BenjaminHab/mad-lightning-stick/hardware/logic-board/spotwelder-sch1.png

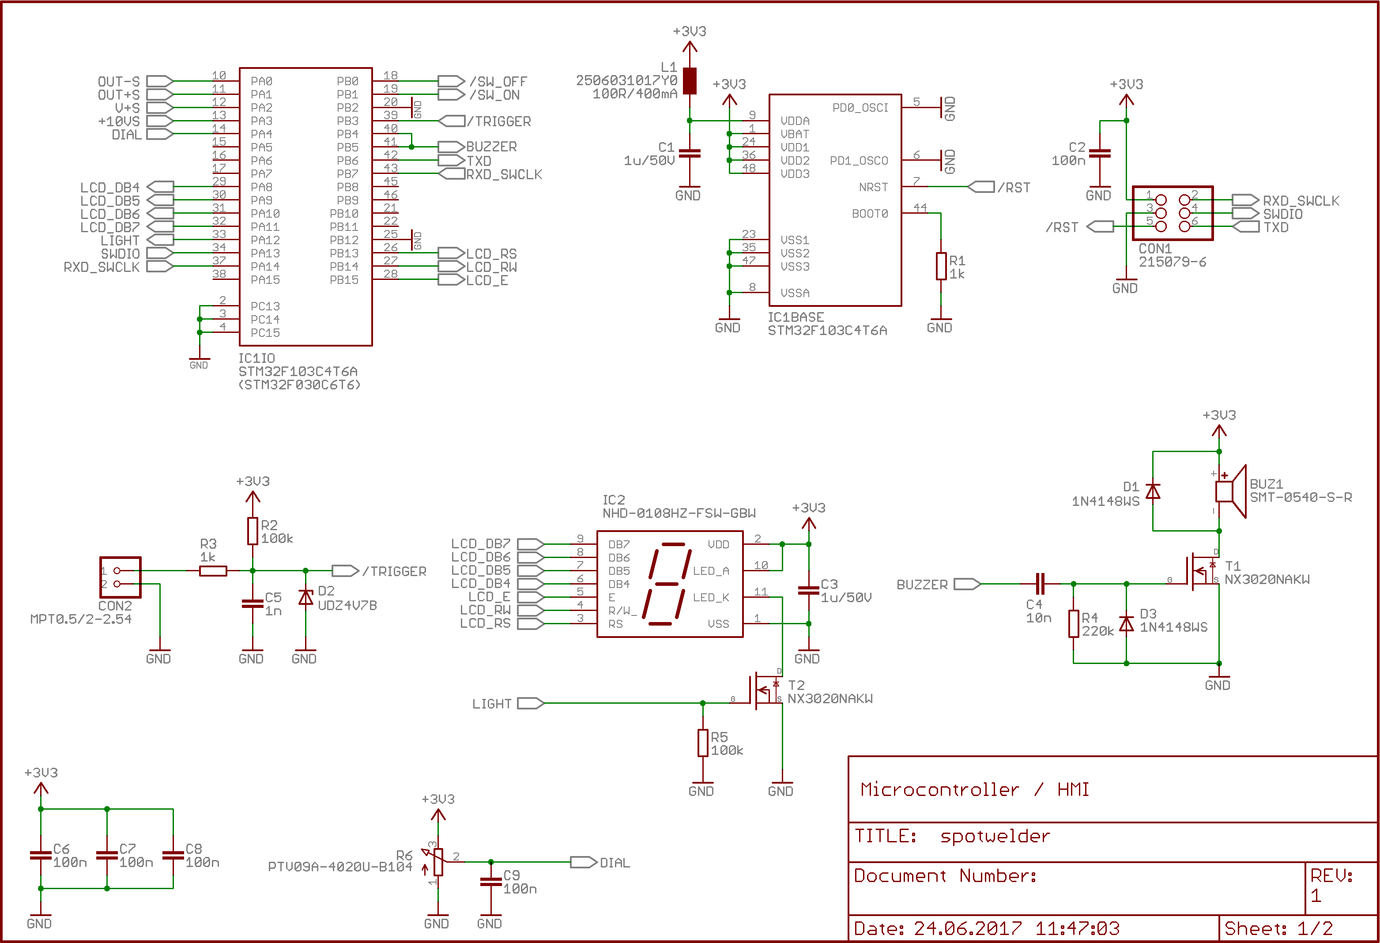
hardware/logic-board/spotwelder-sch1.png
