BenjaminHab/mad-lightning-stick/hardware/logic-board/spotwelder-sch2.png

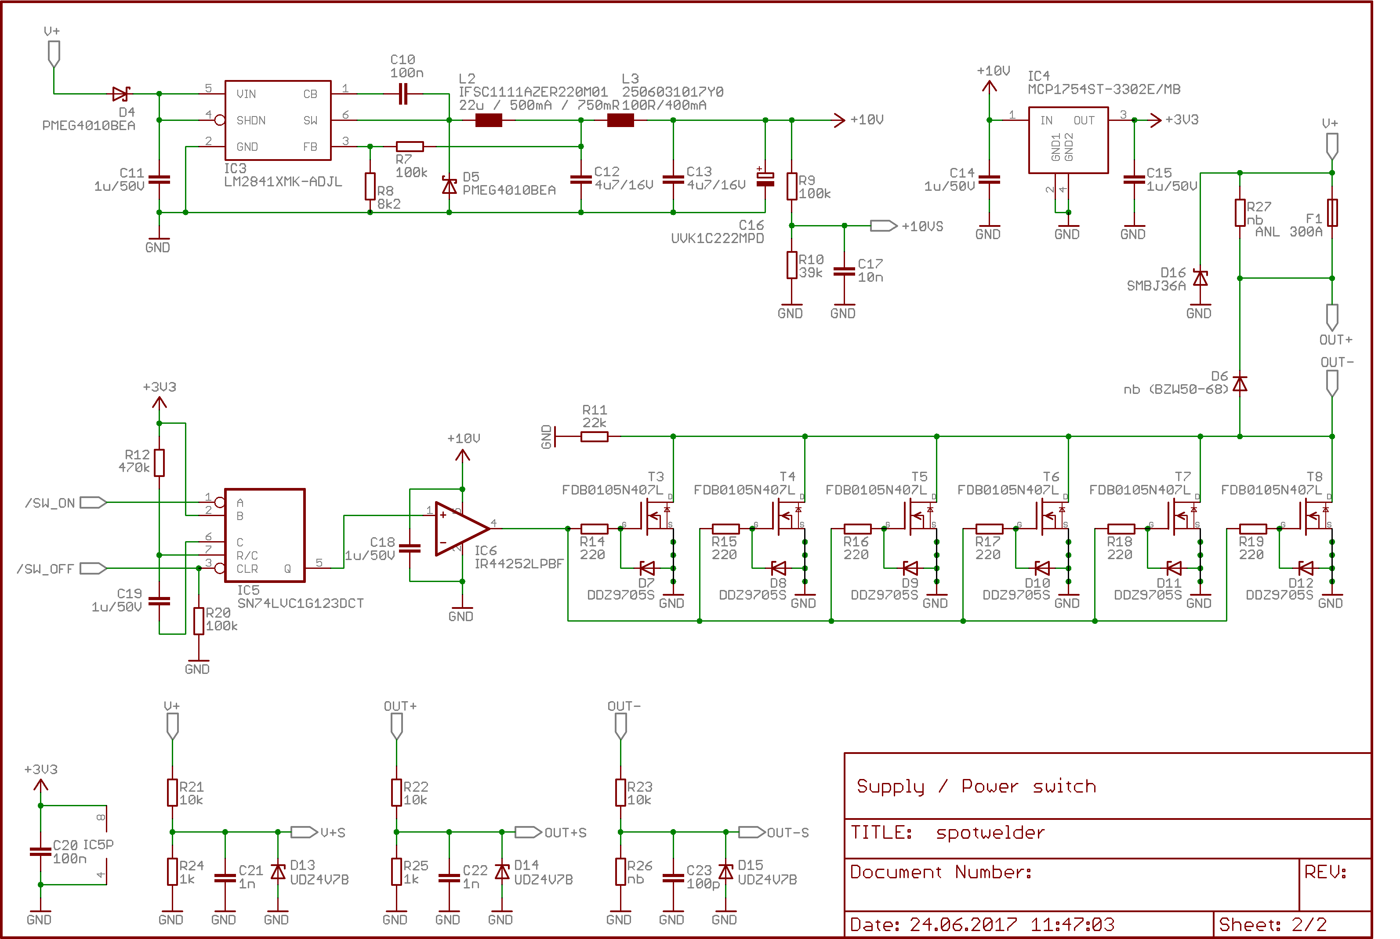
hardware/logic-board/spotwelder-sch2.png
