BenjaminHab/mad-lightning-stick/hardware/logic-board/pawelder_logic_3d_parts.obj

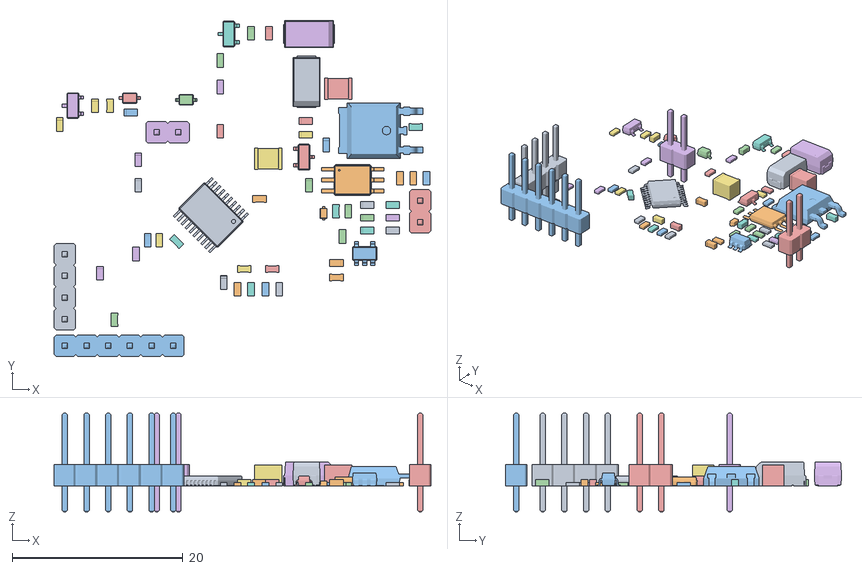
[picture p4: CAD file, 2020-11-03]
hardware/logic-board/pawelder_logic_3d_parts.obj
44.1 x 39.4 x 11.5
