BenjaminHab/mad-lightning-stick/hardware/logic-board/Stencil/Pulse_Arc_Welder_logic-Edge.Cuts.dxf

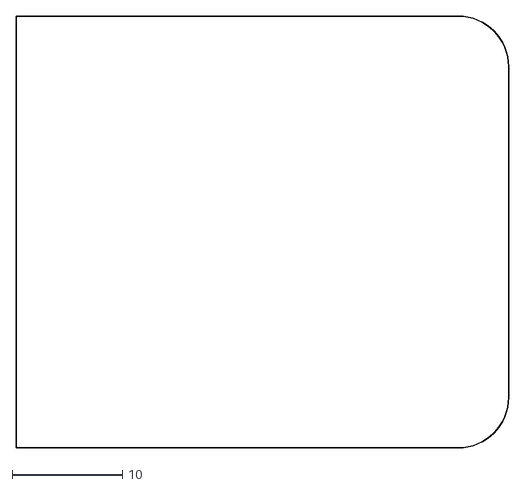
[picture p5: CAD file, 2020-11-03]
hardware/logic-board/Stencil/Pulse_Arc_Welder_logic-Edge.Cuts.dxf
44.7 x 39.2
