BenjaminHab/mad-lightning-stick/hardware/logic-board/Gerber/Pulse_Arc_Welder_logic-Edge_Cuts.dxf

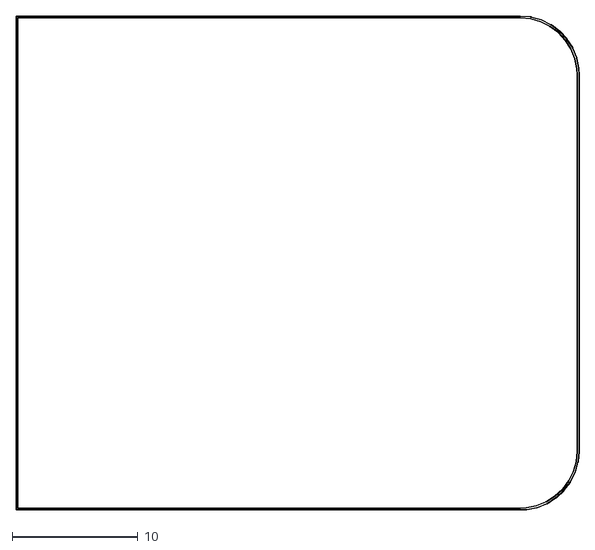
[picture p6: CAD file, 2020-11-03]
hardware/logic-board/Gerber/Pulse_Arc_Welder_logic-Edge_Cuts.dxf
44.8 x 39.4
