BenjaminHab/mad-lightning-stick/hardware/logic-board/pawelder_logic_3d_board.obj

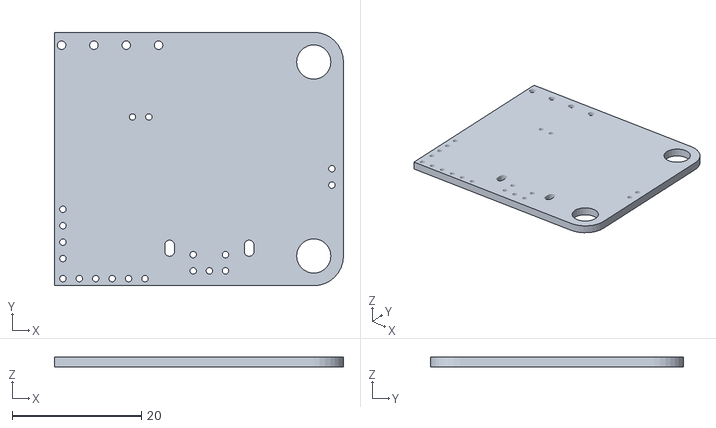
[picture p7: CAD file, 2020-11-03]
hardware/logic-board/pawelder_logic_3d_board.obj
44.7 x 39.2 x 1.60
