BenjaminHab/mad-lightning-stick/hardware/logic-board/Stencil/stencil.stl

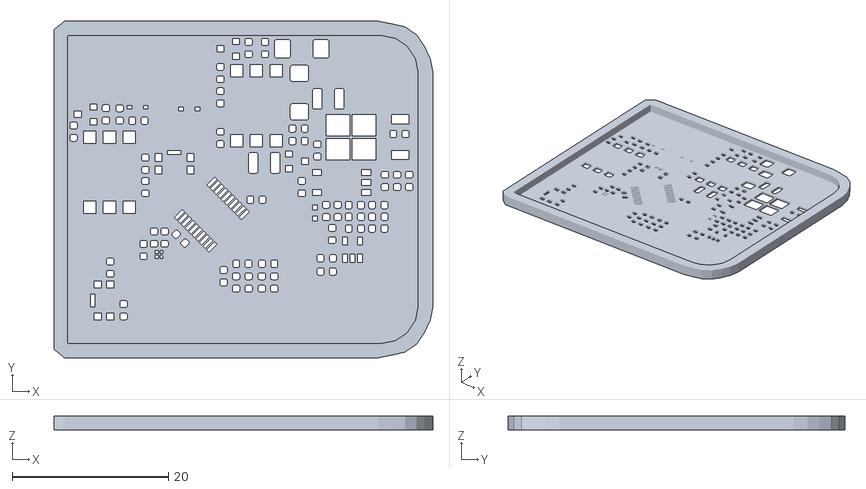
[picture p8: CAD file, 2020-11-03]
hardware/logic-board/Stencil/stencil.stl
48.5 x 43.1 x 1.80
