BenjaminHab/mad-lightning-stick/hardware/logic-board/Gerber/Pulse_Arc_Welder_logic-B_Cu.dxf

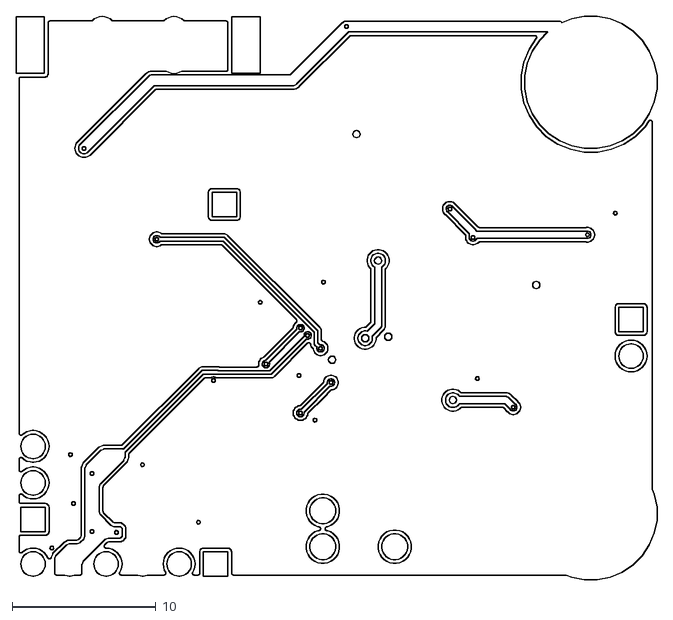
[picture p9: CAD file, 2020-11-03]
hardware/logic-board/Gerber/Pulse_Arc_Welder_logic-B_Cu.dxf
44.6 x 39.2
