BenjaminHab/mad-lightning-stick/hardware/logic-board/pawelder_logic.FCStd

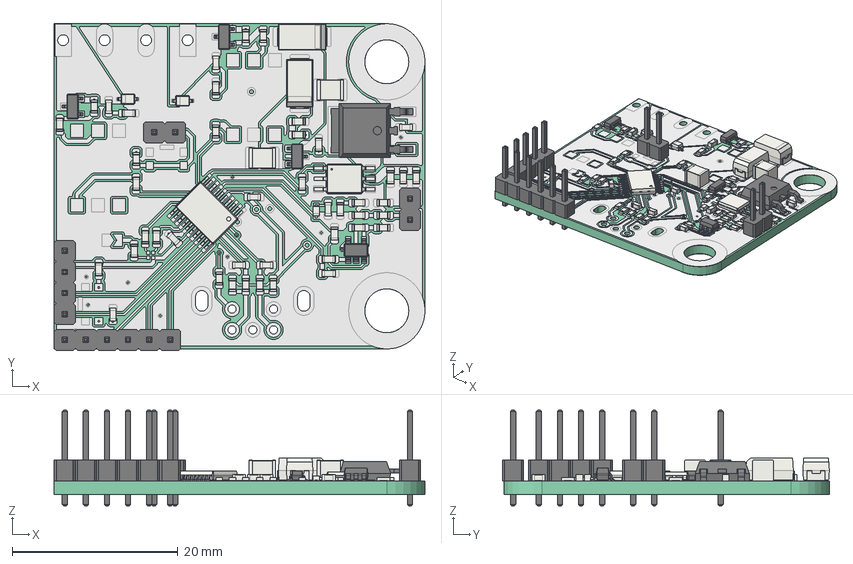
[picture p10: CAD file, 2020-11-03]
hardware/logic-board/pawelder_logic.FCStd
44.7 x 39.4 x 11.5 mm
Pcb
topTracks
botTracks
J5_PinHeader_1x04_P254mm_Vertical_5D2B7882
C14_C_0603_1608Metric_5D2A8FDC
C13_C_0603_1608Metric_5D1FA7F5
U8_SOT_23_5_5D1FA2A7
R34_R_0603_1608Metric_5D2B9920
R35_R_0603_1608Metric_5D1F9F1A
C4_C_1210_3225Metric_5D302AFB
J2_PinHeader_1x02_P254mm_Vertical_5D0663BB
J4_PinHeader_1x02_P254mm_Vertical_5D3E7BC8
U1_TO_252_2_5D3C8292
C5_C_0603_1608Metric_5D06B220
C6_C_0603_1608Metric_5D302B7D
C12_C_0603_1608Metric_5D3D0735
C11_C_0603_1608Metric_5D302B6B
C7_C_0603_1608Metric_5D302B0B
C2_C_1210_3225Metric_5D302AEB
R28_R_0603_1608Metric_5D302303
R29_R_0603_1608Metric_5D3D085B
R30_R_0603_1608Metric_5D3022E1
R31_R_0603_1608Metric_5D3022D0
R32_R_0603_1608Metric_5D3022BF
C10_C_0603_1608Metric_5D2450C5
C9_C_0603_1608Metric_5D2450B4
C8_C_0603_1608Metric_5D245092
C1_CP_EIA_6032_28_Kemet_C_5D245070
C3_CP_EIA_6032_28_Kemet_C_5D24505D
SWD1_PinHeader_1x06_P254mm_Vertical_5D067C02
U6_SO_6_44x36mm_P127mm_5D244F95
D2_D_SOD_323_5D244F80
D3_D_SOD_323_5D066876
D1_D_SOD_523_5D3112F9
U3_TSSOP_20_44x65mm_P065mm_5D244EE0
U2_SOT_23_5D244EBC
Q2_SOT_23_5D3D0799
Q1_SOT_23_5D244E92
R12_R_0603_1608Metric_5D244E55
R19_R_0603_1608Metric_5D3D0765
R10_R_0603_1608Metric_5D244E33
R9_R_0603_1608Metric_5D068CD0
R8_R_0603_1608Metric_5D244E11
R7_R_0603_1608Metric_5D06490D
R1_R_0603_1608Metric_5D244DEF
R2_R_0603_1608Metric_5D244DDE
R3_R_0603_1608Metric_5D244DCD
R4_R_0603_1608Metric_5D244DBC
R5_R_0603_1608Metric_5D244DAB
R11_R_0603_1608Metric_5D244D9A
R20_R_0603_1608Metric_5D244D89
R24_R_0603_1608Metric_5D244D78
R18_R_0603_1608Metric_5D3D07D1
R27_R_0603_1608Metric_5D244D56
R26_R_0603_1608Metric_5D244D45
R25_R_0603_1608Metric_5D244D34
R13_R_0603_1608Metric_5D067DBD
R23_R_0603_1608Metric_5D244D12
R22_R_0603_1608Metric_5D244D01
R21_R_0603_1608Metric_5D244CF0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
