BenjaminHab/mad-lightning-stick/hardware/logic-board/pawelder_logic_3d_top.obj

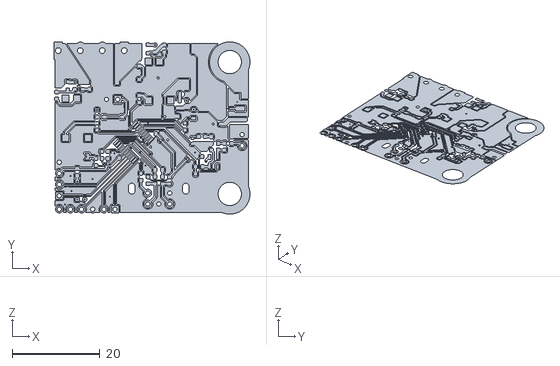
[picture p11: CAD file, 2020-11-03]
hardware/logic-board/pawelder_logic_3d_top.obj
44.6 x 39.2 x 0.04
