BenjaminHab/mad-lightning-stick/(list of files, cad)

Other CAD files:
hardware/logic-board/pawelder_logic_3d.obj
hardware/logic-board/Gerber/Pulse_Arc_Welder_logic-B.Paste.dxf
hardware/logic-board/Gerber/Pulse_Arc_Welder_logic-F.Paste.dxf
hardware/logic-board/Gerber/Pulse_Arc_Welder_logic-F_Paste.dxf
hardware/logic-board/Stencil/Pulse_Arc_Welder_logic-F.Paste.dxf
hardware/logic-board/Stencil_05/Pulse_Arc_Welder_logic-F.Paste.dxf
hardware/logic-board/Stencil_10/Pulse_Arc_Welder_logic-F.Paste.dxf
