BenjaminHab/mad-lightning-stick/hardware/logic-board/Projected Changes.odt

Changes for next iteration:

- Change RGB LED to make the colours work as intended

- Use a processor with more Flash Memory (STM32F07x or STM32G0xx)

- Check for open connections (Current measurement!)
