BenjaminHab/mad-lightning-stick/hardware/logic-board/Pulse_Arc_Welder_logic.pdf

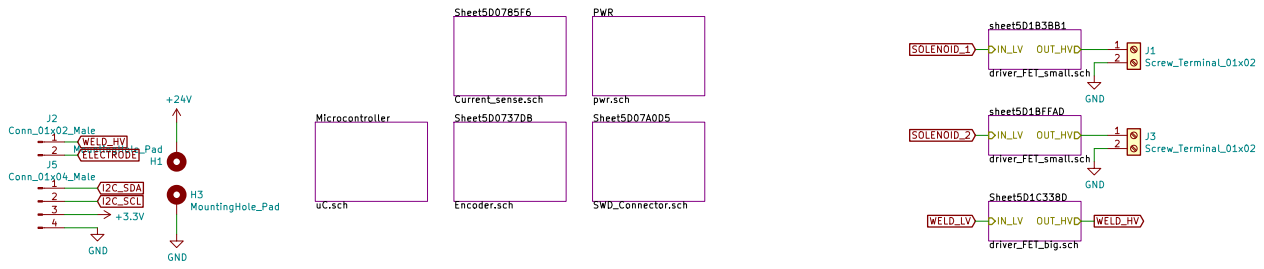
[picture p12: page 1]

pwr.sch Microcontroller uC.sch

File: Pulse_Arc_Welder_logic.sch Sheet: /
Id: 1/9 Title: pawelder logic

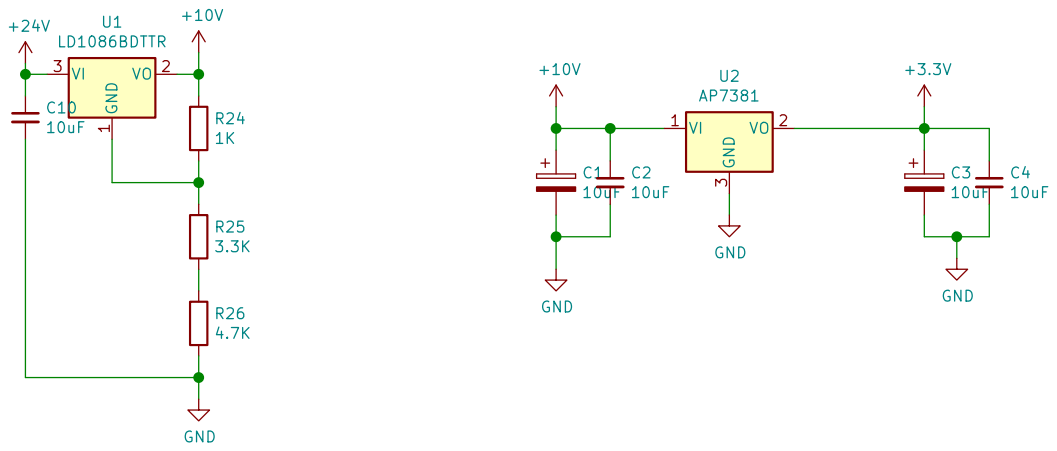
[picture p13: page 2]

3 U2 AP7381 GND GND GND GND

File: pwr.sch Sheet: /PWR/
Id: 2/9 Title: pawelder logic

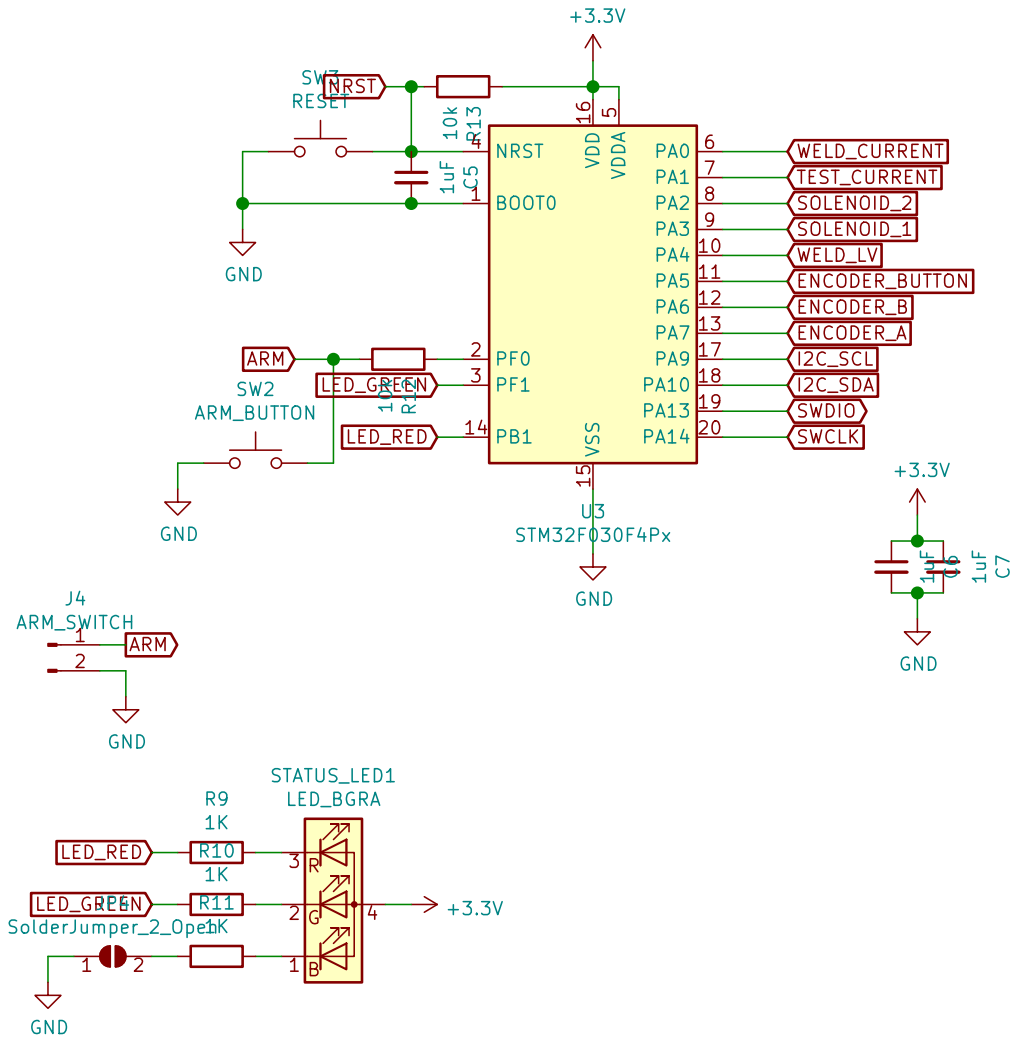
[picture p14: page 3]

File: uC.sch Sheet: /Microcontroller/ 10k R13 SW2 ARM_BUTTON

Id: 3/9 Title: pawelder logic

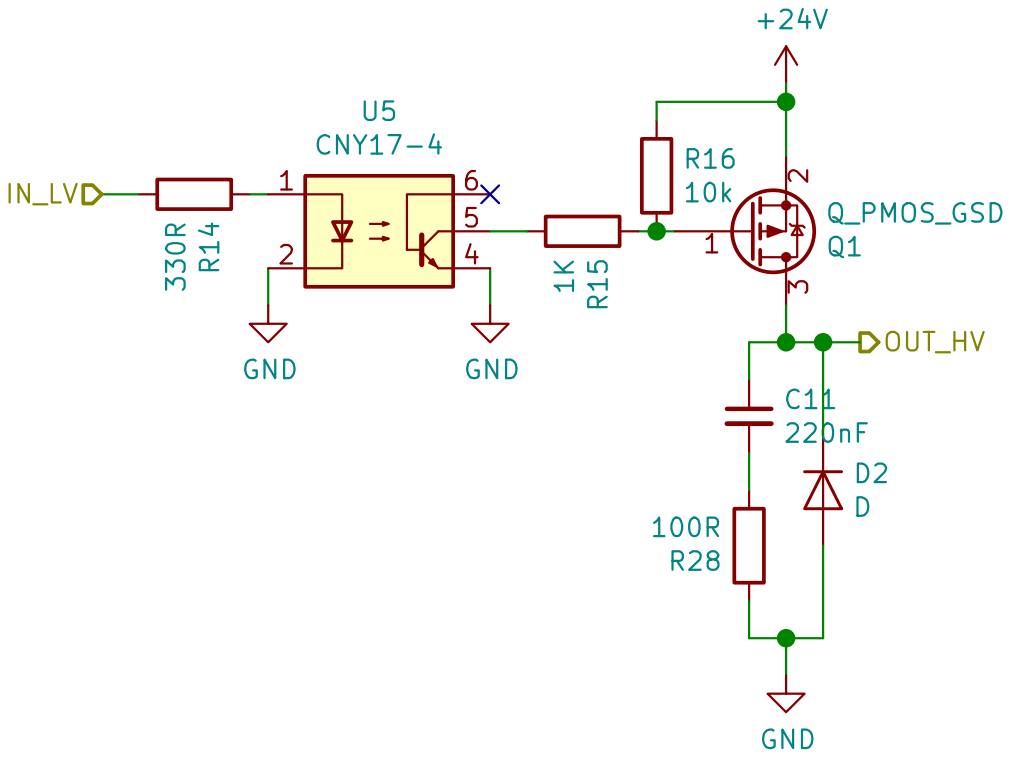
[picture p15: page 4]

File: driver_FET_small.sch Sheet: /sheet5D1B3BB1/
Id: 4/9 Title: pawelder logic

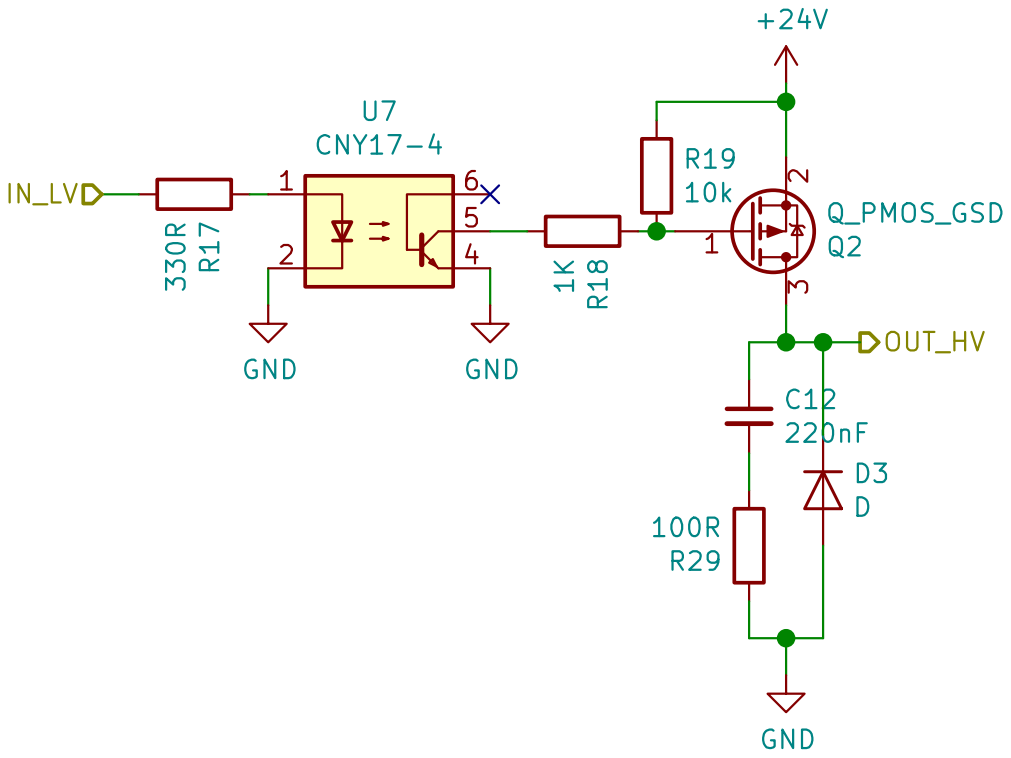
[picture p16: page 5]

File: driver_FET_small.sch Sheet: /sheet5D1BFFAD/
Id: 5/9 Title: pawelder logic

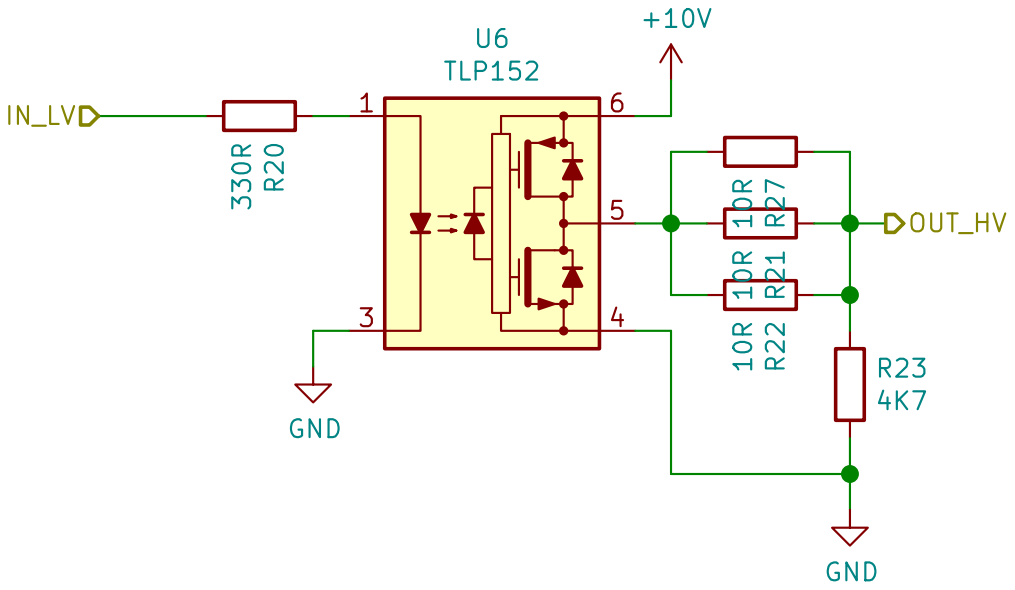
[picture p17: page 6]

File: driver_FET_big.sch Sheet: /Sheet5D1C338D/
Id: 6/9 Title: pawelder logic

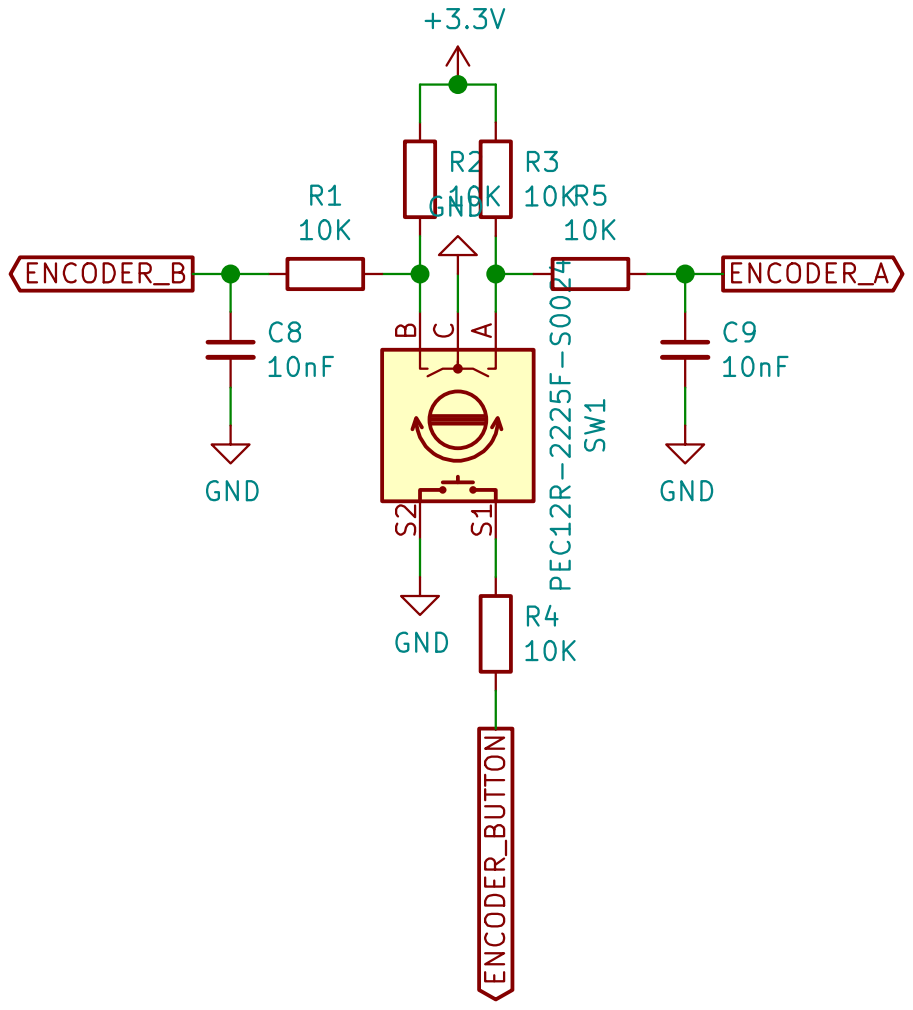
[picture p18: page 7]

File: Encoder.sch Sheet: /Sheet5D0737DB/
Id: 7/9 Title: pawelder logic

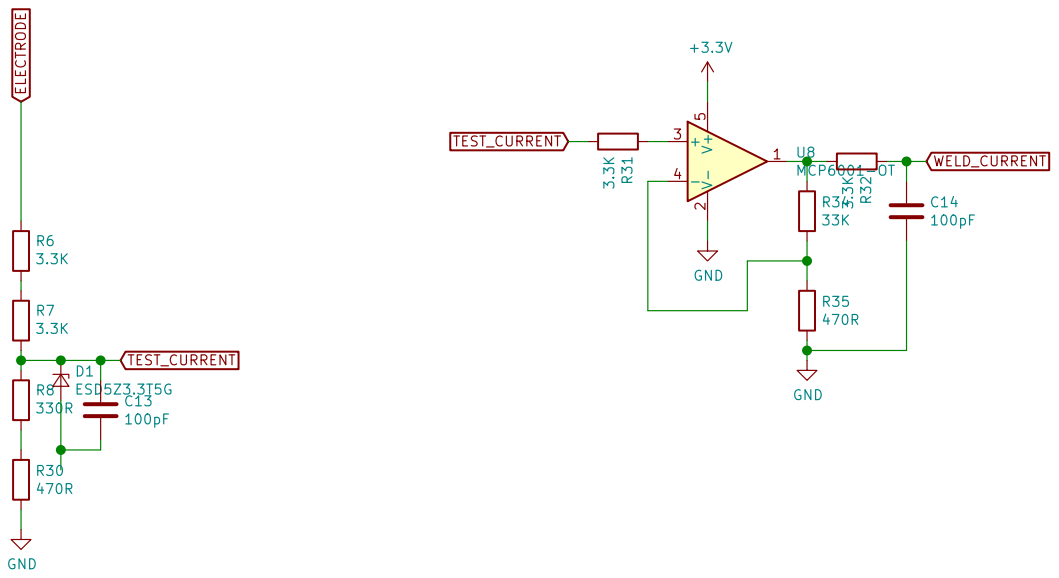
[picture p19: page 8]

File: Current_sense.sch Sheet: /Sheet5D0785F6/
Id: 8/9 Title: pawelder logic

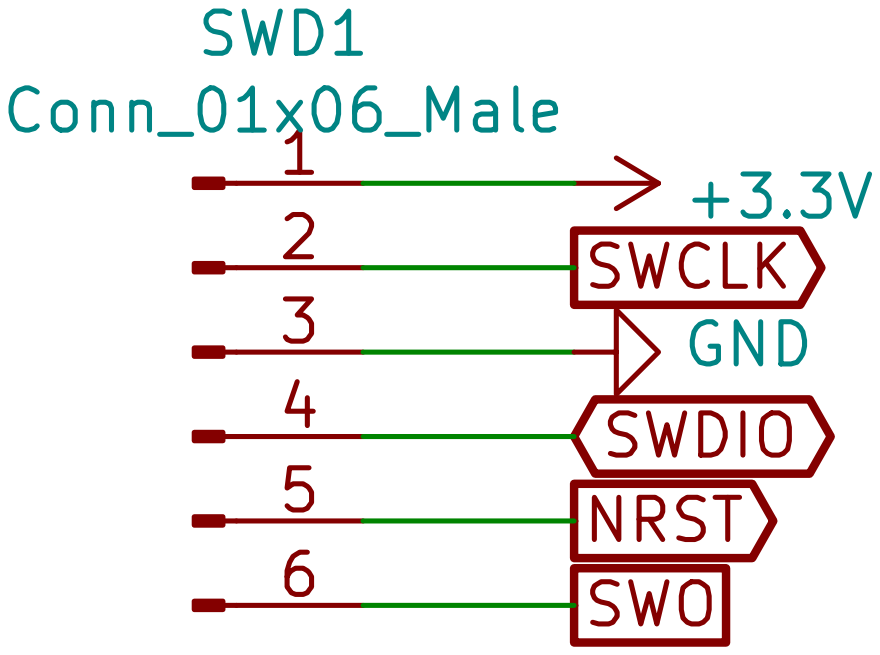
[picture p20: page 9]

File: SWD_Connector.sch Sheet: /Sheet5D07A0D5/
Id: 9/9 Title: pawelder logic
