BenjaminHab/mad-lightning-stick/hardware/power-board/Pulse_Arc_Welder.kicad_pcb

## KiCad design hardware/power-board/Pulse_Arc_Welder.kicad_pcb (2022-05-19)

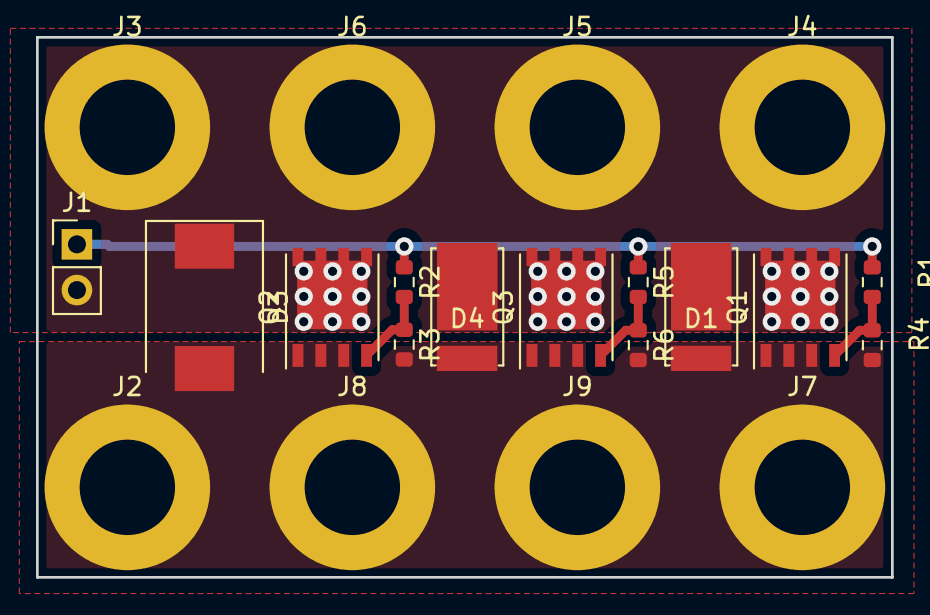
[picture p21: board Pulse_Arc_Welder.kicad_pcb from above]

Board: 2 copper layers, 47.5 x 30.0 mm, 21 parts (0 on the bottom side), 6 nets.

Parts:
D1, D4: SBR10U45SP5; powerdi5
D3: 24V; D_SMC
J1: to logic board; PinHeader_1x02_P2.54mm_Vertical
J2, J7, J8, J9: BAT-; MountingHole_5.3mm_M5_DIN965_Pad
J3, J4, J5, J6: Electrode; MountingHole_5.3mm_M5_DIN965_Pad
Q1, Q2, Q3: SIR500DP-T1-RE3; PowerPAK_SO-8_Single
R1, R2, R5: 10R; R_0603_1608Metric
R3, R4, R6: 10k; R_0603_1608Metric

Connections:
Electrode: D1.1 (K), D3.1 (K), D4.1 (K), J1.2, J3.1, J4.1, J5.1, J6.1, Q1.5 (D), Q2.5 (D), Q3.5 (D)
GND: D1.2 (A), D3.2 (A), D4.2 (A), J2.1, J7.1, J8.1, J9.1, Q1.1 (S), Q1.2 (S), Q1.3 (S), Q2.1 (S), Q2.2 (S), Q2.3 (S), Q3.1 (S), Q3.2 (S), Q3.3 (S), R3.2, R4.2, R6.2
unnamed: Q2.4 (G), R2.2, R3.1
unnamed: Q3.4 (G), R5.2, R6.1
unnamed: Q1.4 (G), R1.2, R4.1
SIG: J1.1, R1.1, R2.1, R5.1
