BenjaminHab/mad-lightning-stick/hardware/logic-board/Pulse_Arc_Welder_logic.kicad_pcb

## KiCad design hardware/logic-board/Pulse_Arc_Welder_logic.kicad_pcb (2020-11-03)

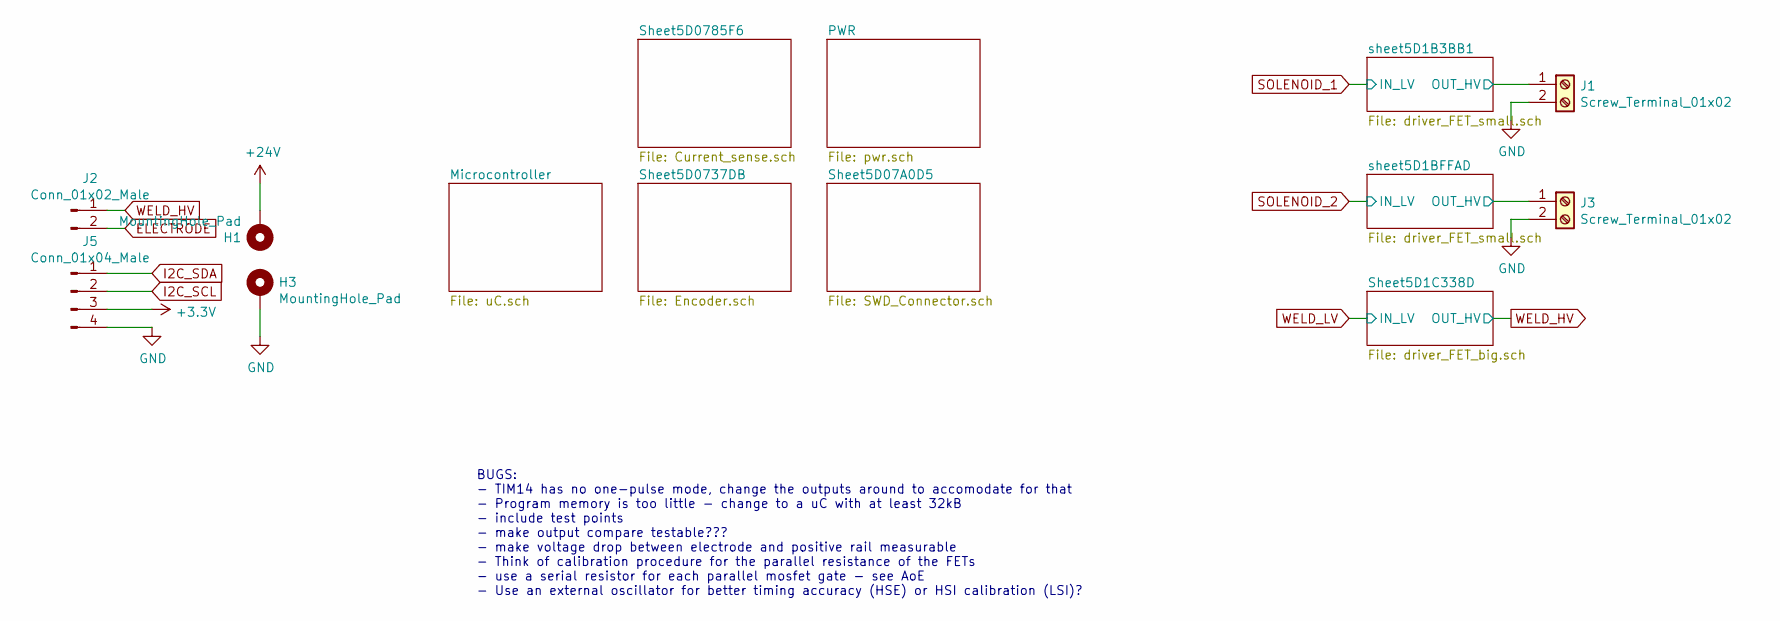
[picture p22: schematic Pulse_Arc_Welder_logic.sch, pawelder logic]

Parts:
H1, H3: MountingHole_Pad; MountingHole_5.3mm_M5_DIN965_Pad
J1, J3: Screw_Terminal_01x02; TerminalBlock_Altech_AK300-2_P5.00mm
J2: Conn_01x02_Male; PinHeader_1x02_P2.54mm_Vertical
J5: Conn_01x04_Male; PinHeader_1x04_P2.54mm_Vertical

Connections:
+3V3: J5.3; also elsewhere on the board
+24V: H1.1; also elsewhere on the board
/sheet5D1B3BB1/OUT_HV: J1.1; also elsewhere on the board
/sheet5D1BFFAD/OUT_HV: J3.1; also elsewhere on the board
ELECTRODE: J2.2; also elsewhere on the board
I2C_SCL: J5.2; also elsewhere on the board
I2C_SDA: J5.1; also elsewhere on the board
WELD_HV: J2.1; also elsewhere on the board

Notes on the sheet:
BUGS: - TIM14 has no one-pulse mode, change the outputs around to accomodate for that - Program memory is too little - change to a uC with at least 32kB - include test points - make output compare testable??? - make voltage drop between electrode and positive rail measurable - Think of calibration 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

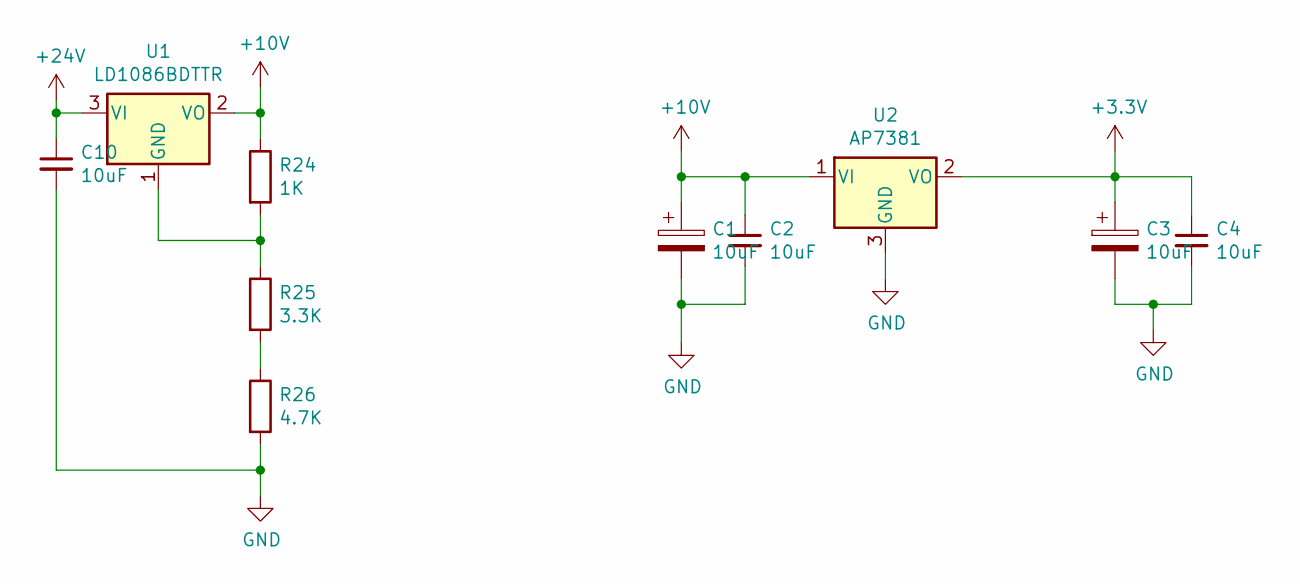
[picture p23: schematic pwr.sch, pawelder logic]

Parts:
C1, C3: 10uF; CP_EIA-6032-28_Kemet-C
C2, C4: 10uF; C_1210_3225Metric
C10: 10uF; C_0603_1608Metric
R24: 1K; R_0603_1608Metric
R25: 3.3K; R_0603_1608Metric
R26: 4.7K; R_0603_1608Metric
U1: LD1086BDTTR; TO-252-2
U2: AP7381; SOT-23

Connections:
+3V3: C3.1, C4.1, U2.2 (VO); also elsewhere on the board
+10V: C1.1, C2.1, R24.1, U1.2 (VO), U2.1 (VI); also elsewhere on the board
+24V: C10.1, U1.3 (VI); also elsewhere on the board
unnamed: R24.2, R25.1, U1.1 (GND)
unnamed: R25.2, R26.1

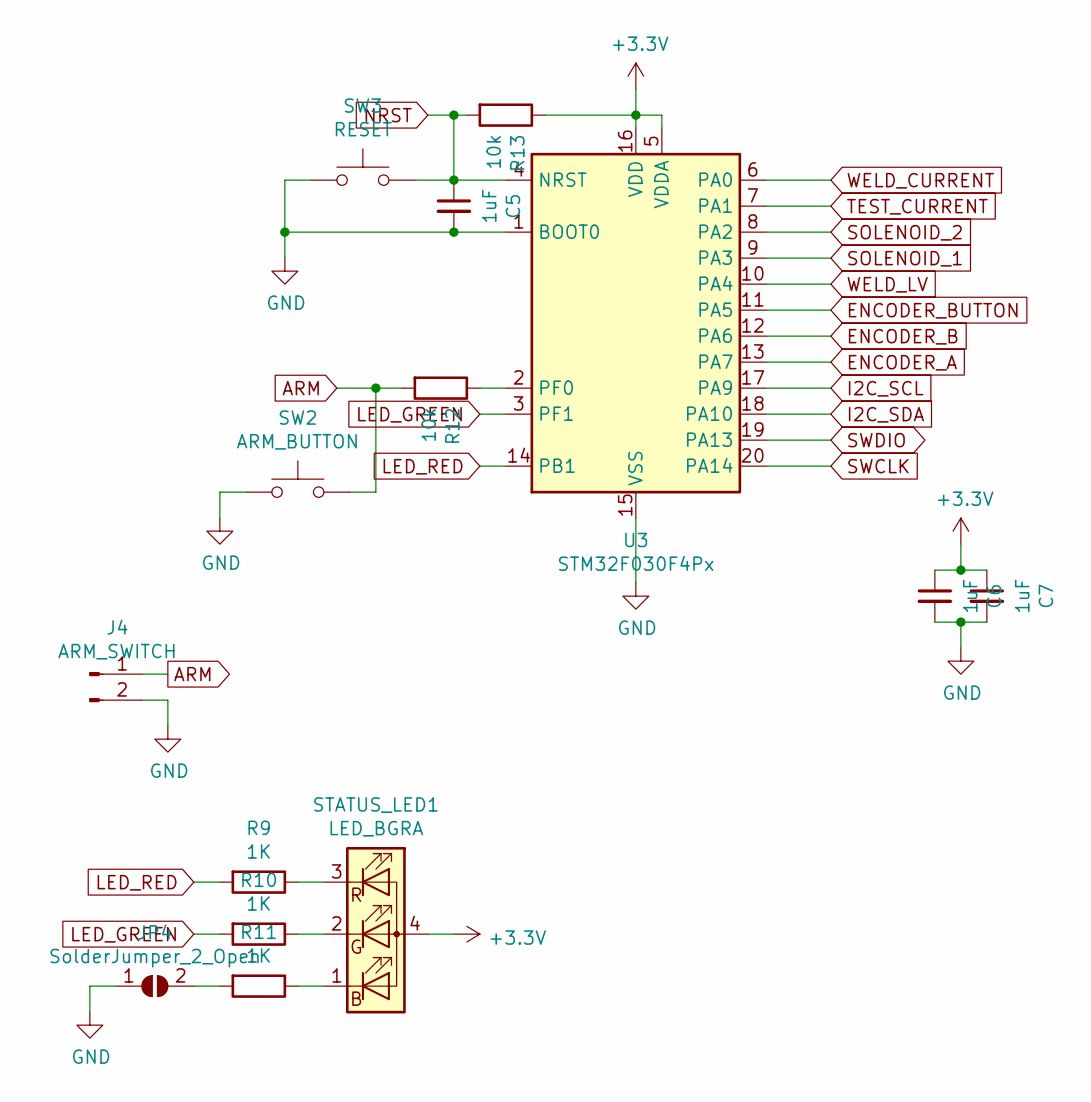
[picture p24: schematic uC.sch, pawelder logic]

Parts:
C5, C6, C7: 1uF; C_0603_1608Metric
J4: ARM_SWITCH; PinHeader_1x02_P2.54mm_Vertical
JP4: SolderJumper_2_Open; SolderJumper-2_P1.3mm_Open_TrianglePad1.0x1.5mm
R9, R10, R11: 1K; R_0603_1608Metric
R12, R13: 10k; R_0603_1608Metric
STATUS_LED1: LED_BGRA
SW2: ARM_BUTTON; KMR7_SWITCH
SW3: RESET; KMR7_SWITCH
U3: STM32F030F4Px; TSSOP-20_4.4x6.5mm_P0.65mm

Connections:
+3V3: C6.1, C7.1, R13.1, STATUS_LED1.4 (A), U3.5 (VDDA), U3.16 (VDD); also elsewhere on the board
ARM: J4.1, R12.2, SW2.2
ENCODER_A: U3.13 (PA7); also elsewhere on the board
ENCODER_B: U3.12 (PA6); also elsewhere on the board
ENCODER_BUTTON: U3.11 (PA5); also elsewhere on the board
I2C_SCL: U3.17 (PA9); also elsewhere on the board
I2C_SDA: U3.18 (PA10); also elsewhere on the board
LED_GREEN: R10.2, U3.3 (PF1)
LED_RED: R9.2, U3.14 (PB1)
NRST: C5.1, R13.2, SW3.2, U3.4 (NRST); also elsewhere on the board
unnamed: JP4.2 (B), R11.2
unnamed: R9.1, STATUS_LED1.3 (RK)
unnamed: R10.1, STATUS_LED1.2 (GK)
unnamed: R11.1, STATUS_LED1.1 (BK)
unnamed: R12.1, U3.2 (PF0)
SOLENOID_1: U3.9 (PA3); also elsewhere on the board
SOLENOID_2: U3.8 (PA2); also elsewhere on the board
SWCLK: U3.20 (PA14); also elsewhere on the board
SWDIO: U3.19 (PA13); also elsewhere on the board
TEST_CURRENT: U3.7 (PA1); also elsewhere on the board
WELD_CURRENT: U3.6 (PA0); also elsewhere on the board
WELD_LV: U3.10 (PA4); also elsewhere on the board

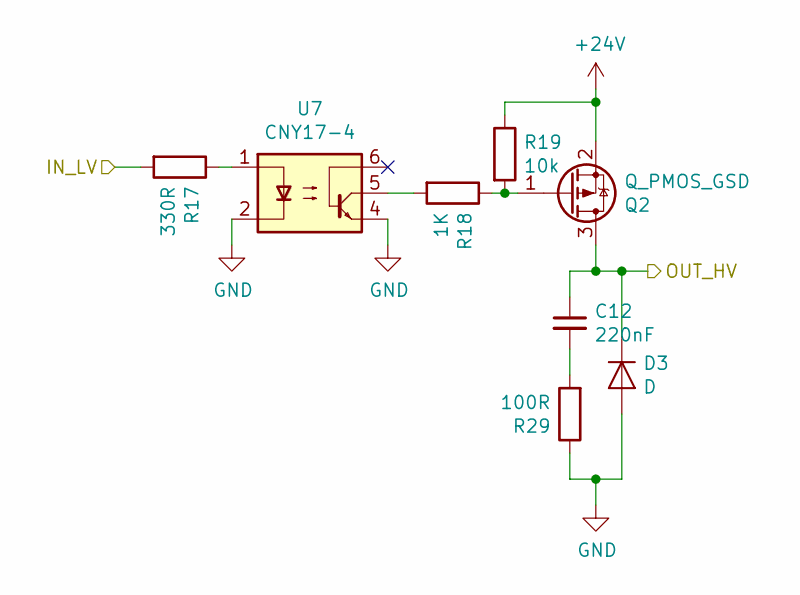
[picture p25: schematic driver_FET_small.sch, pawelder logic]

Parts:
C11: 220nF; C_0603_1608Metric
D2: D; D_SOD-323
Q1: Q_PMOS_GSD; SOT-23
R14: 330R; R_0603_1608Metric
R15: 1K; R_0603_1608Metric
R16: 10k; R_0603_1608Metric
R28: 100R; R_0603_1608Metric
U7: CNY17-4; PDIP-6

Connections:
+24V: Q1.2 (S), R16.1; also elsewhere on the board
/sheet5D1B3BB1/OUT_HV: C11.1, D2.1 (K), Q1.3 (D); also elsewhere on the board
unnamed: C11.2, R28.2
unnamed: Q1.1 (G), R15.1, R16.2
SOLENOID_1: R14.2; also elsewhere on the board

Parts of its further copies:
C12: 220nF; C_0603_1608Metric
D3: D; D_SOD-323
Q2: Q_PMOS_GSD; SOT-23
R17: 330R; R_0603_1608Metric
R18: 1K; R_0603_1608Metric
R19: 10k; R_0603_1608Metric
R29: 100R; R_0603_1608Metric
U5: CNY17-4; PDIP-6

Connections of its further copies:
+24V: Q2.2 (S), R19.1; also elsewhere on the board
/sheet5D1BFFAD/OUT_HV: C12.1, D3.1 (K), Q2.3 (D); also elsewhere on the board
unnamed: C12.2, R29.2
unnamed: Q2.1 (G), R18.1, R19.2
SOLENOID_2: R17.2; also elsewhere on the board

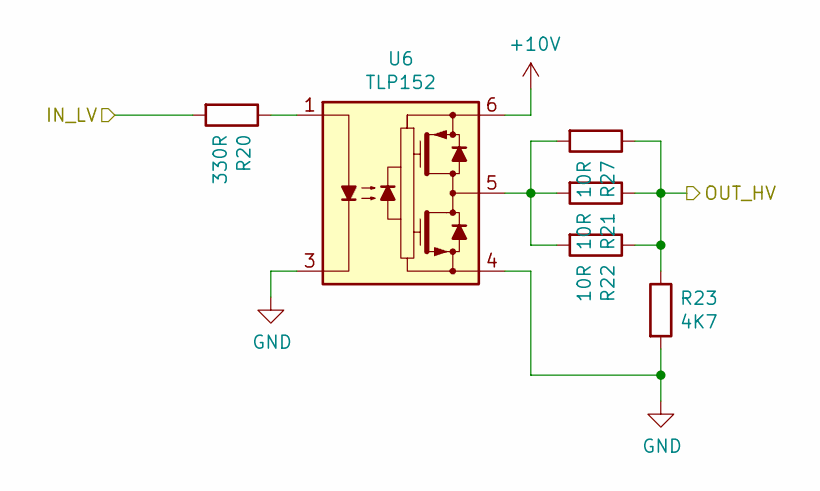
[picture p26: schematic driver_FET_big.sch, pawelder logic]

Parts:
R20: 330R; R_0603_1608Metric
R21, R22, R27: 10R; R_0603_1608Metric
R23: 4K7; R_0603_1608Metric
U6: TLP152; SO-6_5PIN

Connections:
+10V: U6.6 (VCC); also elsewhere on the board
unnamed: R20.1, U6.1 (A)
unnamed: R21.2, R22.2, R27.2, U6.5 (VO)
WELD_HV: R21.1, R22.1, R23.1, R27.1; also elsewhere on the board
WELD_LV: R20.2; also elsewhere on the board

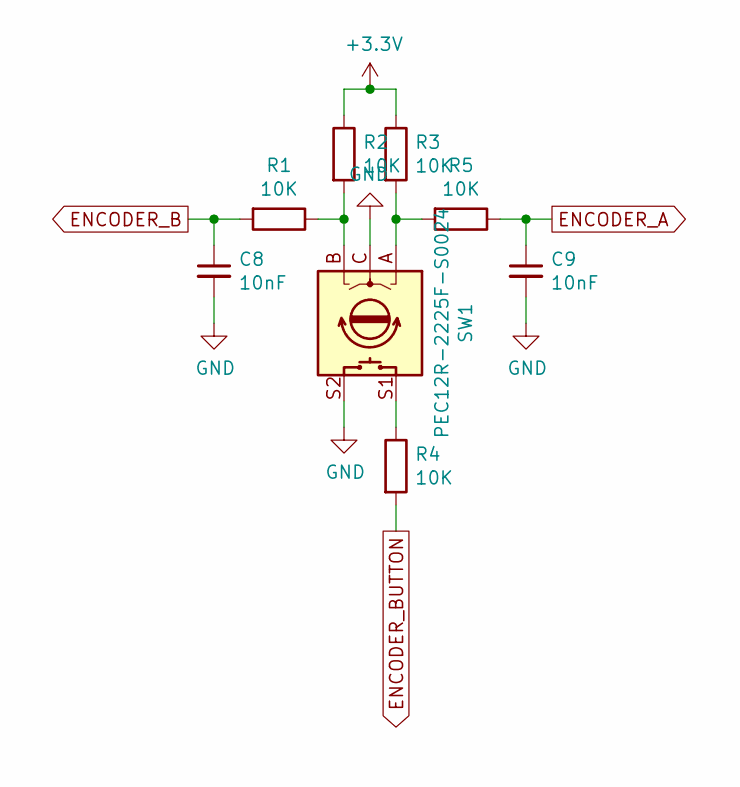
[picture p27: schematic Encoder.sch, pawelder logic]

Parts:
C8, C9: 10nF; C_0603_1608Metric
R1, R2, R3, R4, R5: 10K; R_0603_1608Metric
SW1: PEC12R-2225F-S0024; ENCODER_BOURNS

Connections:
+3V3: R2.1, R3.1; also elsewhere on the board
ENCODER_A: C9.1, R5.1; also elsewhere on the board
ENCODER_B: C8.1, R1.2; also elsewhere on the board
ENCODER_BUTTON: R4.2; also elsewhere on the board
unnamed: R1.1, R2.2, SW1.B
unnamed: R3.2, R5.2, SW1.A
unnamed: R4.1, SW1.S1

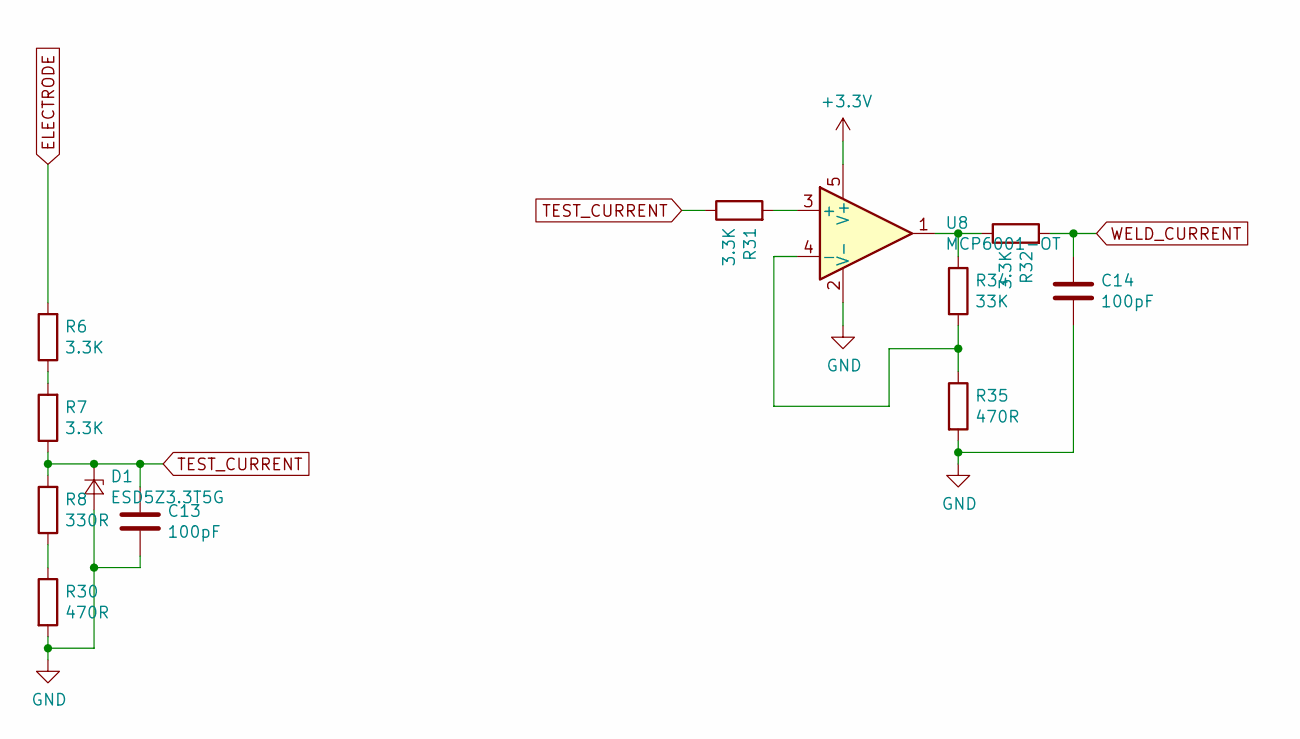
[picture p28: schematic Current_sense.sch, pawelder logic]

Parts:
C13, C14: 100pF; C_0603_1608Metric
D1: ESD5Z3.3T5G; D_SOD-523
R6, R7, R31, R32: 3.3K; R_0603_1608Metric
R8: 330R; R_0603_1608Metric
R30, R35: 470R; R_0603_1608Metric
R34: 33K; R_0603_1608Metric
U8: MCP6001-OT; SOT-23-5

Connections:
+3V3: U8.5 (V+); also elsewhere on the board
ELECTRODE: R6.2; also elsewhere on the board
unnamed: R6.1, R7.2
unnamed: R8.1, R30.1
unnamed: R31.2, U8.3 (+)
unnamed: R32.1, R34.1, U8.1
unnamed: R34.2, R35.1, U8.4 (-)
TEST_CURRENT: C13.1, D1.1 (K), R7.1, R8.2, R31.1; also elsewhere on the board
WELD_CURRENT: C14.1, R32.2; also elsewhere on the board

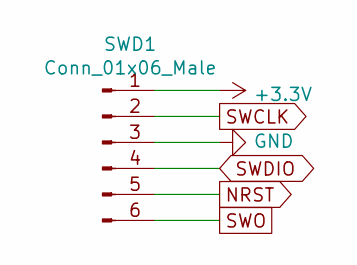
[picture p29: schematic SWD_Connector.sch, pawelder logic]

Parts:
SWD1: Conn_01x06_Male; PinHeader_1x06_P2.54mm_Vertical

Connections:
+3V3: SWD1.1; also elsewhere on the board
NRST: SWD1.5; also elsewhere on the board
SWCLK: SWD1.2; also elsewhere on the board
SWDIO: SWD1.4; also elsewhere on the board
SWO: SWD1.6

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
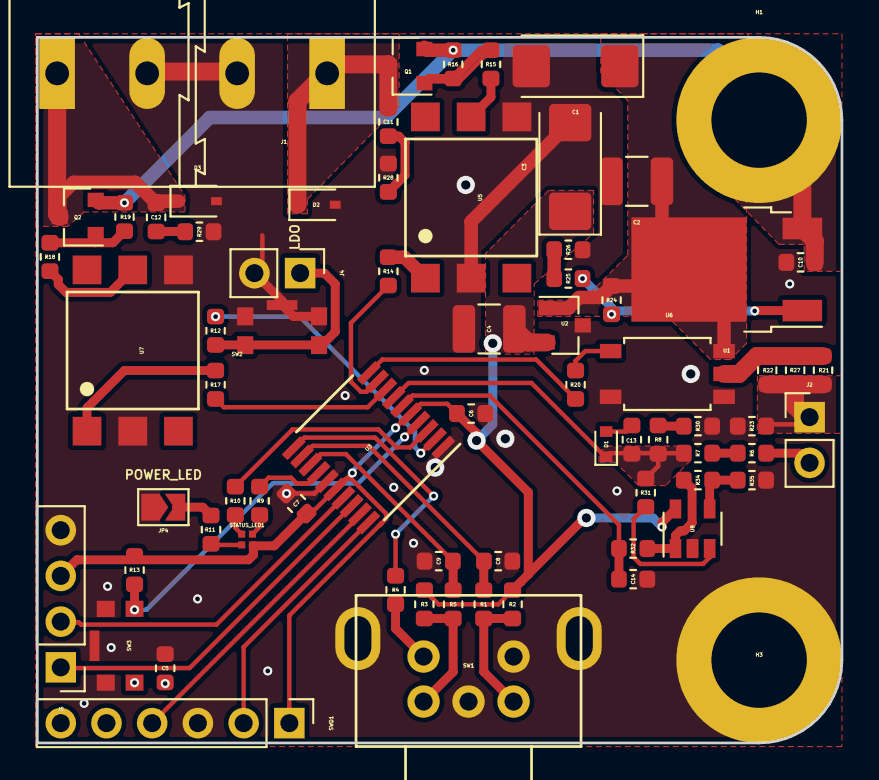
[picture p30: board Pulse_Arc_Welder_logic.kicad_pcb from above]

Board: 2 copper layers, 44.7 x 39.2 mm, 73 parts (0 on the bottom side), 50 nets.
