BenjaminHab/mad-lightning-stick/hardware/logic-board/Pulse_Arc_Welder_logic_r2.kicad_pcb

## KiCad design hardware/logic-board/Pulse_Arc_Welder_logic_r2.kicad_pcb (2020-11-03)

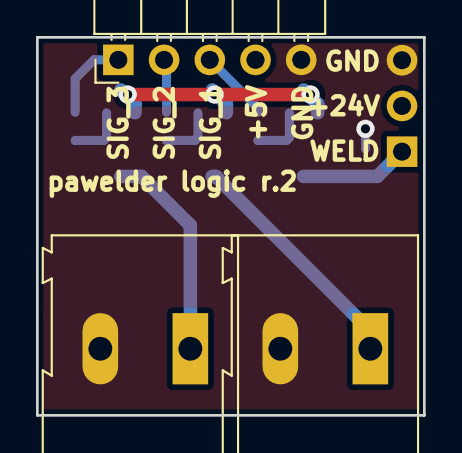
[picture p31: board Pulse_Arc_Welder_logic_r2.kicad_pcb from above]

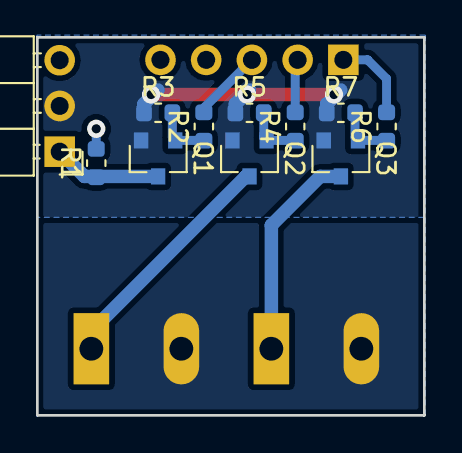
[picture p32: board Pulse_Arc_Welder_logic_r2.kicad_pcb from below]

Board: 2 copper layers, 21.5 x 21.0 mm, 14 parts (11 on the bottom side), 11 nets.

Parts:
J1, J4: Screw_Terminal_01x02; TerminalBlock_Altech_AK300-2_P5.00mm
J2: Conn_01x03_Male; PinHeader_1x03_P2.54mm_Horizontal
J3: Conn_01x05_Male; PinHeader_1x05_P2.54mm_Horizontal
Q1, Q2, Q3: Q_PMOS_GSD; SOT-23
R1, R3, R5, R7: 10k; R_0603_1608Metric
R2, R4, R6: 100; R_0603_1608Metric

Connections:
+24V: J2.2, Q1.2, Q2.2, Q3.2, R3.1, R5.1, R7.1
GND: J1.2, J2.3, J3.5, J4.2, R1.2
unnamed: J1.1, Q3.3
unnamed: J4.1, Q2.3
unnamed: Q1.1, R2.1, R3.2
unnamed: Q2.1, R4.1, R5.2
unnamed: Q3.1, R6.1, R7.2
SIG_1: J3.3, R2.2
SIG_2: J3.2, R4.2
SIG_3: J3.1, R6.2
WELD: J2.1, Q1.3, R1.1
