BenjaminHab/mad-lightning-stick/software/Core/Src/main.cpp

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
/* Includes ------------------------------------------------------------------*/
#include "main.h"
#include "adc.h"
#include "i2c.h"
#include "tim.h"
#include "gpio.h"

/* USER CODE BEGIN Includes */
//TODO: Use Fixed point math library
//#include "fpm/fixed.hpp"


//Modules
#include "Modules.hpp"

/* USER CODE END Includes */


void SystemClock_Config(void);
/**
 * @brief  The application entry point.
 * @retval int
 */
int main(void)
{
	/* MCU Configuration--------------------------------------------------------*/

	/* Reset of all peripherals, Initializes the Flash interface and the Systick. */
	HAL_Init();

	/* Configure the system clock */
	//SystemClock_Config();

	/* USER CODE BEGIN SysInit */
	RCC_Interface rcc;
	rcc.set_system_clock(PLL);

	/* USER CODE END SysInit */

	/* Initialize all configured peripherals */
	//MX_GPIO_Init();
	//MX_ADC_Init();
	MX_I2C1_Init();
	//MX_TIM14_Init();
	//MX_TIM3_Init();
	//	MX_TIM16_Init();
	/* USER CODE BEGIN 2 */
	//TODO: Initialize Peripherals myself and save lots of memory
	//TODO: Test Modules



	//	 ADC_Test test;
	// Menu_Test test;
	//  Pulse_Test test;

	//  Initiate_Pulse_Test test;
	Statemachine_Test test;


	/* USER CODE END 2 */

	/* Infinite loop */
	/* USER CODE BEGIN WHILE */
	while (1)
	{
		/* USER CODE END WHILE */

		/* USER CODE BEGIN 3 */

		test.perform();


	}

	/* USER CODE END 3 */
}

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
