BenjaminHab/mad-lightning-stick/software/mad-lightning-stick.ioc

Mcu.UserName=STM32F030F4Px
PA0.GPIO_Label=TEST_CURRENT
PA0.Signal=ADC_IN0
PA1.GPIO_Label=WELD_CURRENT
PA1.Signal=ADC_IN1
PA10.Signal=I2C1_SDA
PA13.Signal=SYS_SWDIO
PA14.Signal=SYS_SWCLK
PA2.GPIO_Label=SOLENOID_1
PA2.Signal=GPIO_Output
PA3.GPIO_Label=SOLENOID_2
PA3.Signal=GPIO_Output
PA4.GPIO_Label=WELD_SIGNAL
PA4.Signal=S_TIM14_CH1
PA5.GPIO_Label=ENCODER_BUTTON
PA5.Signal=GPIO_Input
PA6.GPIO_Label=ENCODER_A
PA6.Signal=S_TIM3_CH1
PA7.GPIO_Label=ENCODER_B
PA7.Signal=S_TIM3_CH2
PA9.Signal=I2C1_SCL
PB1.GPIO_Label=LED
PB1.Signal=GPIO_Output
PF0-OSC_IN.GPIO_Label=ARM
PF0-OSC_IN.Signal=GPIO_Input
