BenjaminHab/mad-lightning-stick/software/Core/Inc/Test_Module.hpp

#ifndef Test_Module_hpp
#define Test_Module_hpp

#include "Modules.hpp"

class Test
{
public:
	Test();
	Peripherals peripherals;
};

class ADC_Test: public Test{
public:
	ADC_Test();

	void perform();

	char* weld_text_str;
	char* test_text_str;
	uint16_t weld_read;
	uint16_t test_read;
	char weld_str[5];
	char test_str[5];
};

class Menu_Test: public Test{
public:
	Menu_Test();
	//void setup();
	void perform();
};

class Pulse_Test: public Test{
public:
	Pulse_Test();
	void perform();
};

class Initiate_Pulse_Test : public Test{
public:
	Initiate_Pulse_Test();
	void perform();
	Input arm;
	setting_t pulsetime_setting;
};

class Statemachine_Test : public Test{
	public:
	Statemachine_Test();
	void perform();
	Statemachine sm;
};


#endif
