BenjaminHab/mad-lightning-stick/(commit log)

2020-11-04 fixed minor statemachine problem
    [Encoder_Module.cpp, Init_Modules.cpp, Peripherals_Module.hpp, Statemachine_Module.cpp, Test_Module.cpp, Test_Module.hpp, main.cpp]
2020-11-05 Fixed statemachine initialization error
    [Init_Modules.cpp]
2020-11-06 Improved ADC Test
2020-11-06 fixed arm button reading in statemachine
    [Init_Modules.cpp, main.cpp]
2022-05-19 Begun work on power board r.3
    [Pulse_Arc_Welder.kicad_pcb, Pulse_Arc_Welder.step, busbars_oberseite.dxf, pawelder_busbar_footprint.FCStd]
