BenjaminHab/mad-lightning-stick/(notices)

Notices in the files:
software/Core/Src/main.cpp:
COPYRIGHT(c) 2019 STMicroelectronics
(C) COPYRIGHT STMicroelectronics *****END OF FILE
